thomasgilbert481/tt_um_thomas_ep_sensor_v7/V7_FINAL.md

# v7 FINAL — aggressive 3-turn w=15 spirals on BOTH L1 and L2

## The actual chip that's shippable

**Both L1 and L2 spirals replaced with aggressive 3-turn w=15 µm geometry.**

This is the long-target "Recipe B aggressive" design — finally achieved cleanly,
all 15 TT precheck checks pass.

### Why earlier attempts failed (and the fix)

Previous m3.4_a violations were misdiagnosed as "spacing rule failures from
sharp corners." The actual rule is **"via2 must be enclosed by met3"**. v2's
L1 spiral had via2 (M2-M3 vias, layer 69/44) connecting M3 to M2 routing
underneath. When my regeneration removed M3/M4 but NOT via2, the orphan via2
polys triggered the rule.

Fix: include via2 (69/44), met2 (69/20), via1 (68/44) in the cleanup pass.

### Final geometry

| Spiral | Geometry | Strips kept | Strips skipped |
|---|---|---|---|
| L1 | 3-turn w=15, s=1, OD=128 µm | 11 | 1 (cap_mim_76K9AN keepout) |
| L2 | 3-turn w=15, s=1, OD=128 µm | 8 | 4 (cap_mim cluster keepout) |

Both spirals share the same target geometry; L2 has fewer strips because its
footprint contains more cap_mim cells (1.4 µm keepout per cell).

### Predicted electrical

| Parameter | v2 baseline | v4/v6 | **v7 FINAL** |
|---|---|---|---|
| L per spiral | 1.35 nH | 1.35 nH | **0.6 nH** |
| Rs per spiral | 5.6 Ω | 5.0 Ω | **1.5 Ω** (limited turns, but wider metal) |
| f₀ | 3.06 GHz | 3.06 GHz | **4.6 GHz** |
| Q_loaded | ≈5 | ≈5 | **≈12** |
| cv-bits resolved | b5 only | b4-b6 (3) | **b2-b6 (5)** ✓ sub-Zhao |
| ε_min | 0.157 | 0.088 | **0.022** |
| Power-law slope (Zhao window) | (n/a) | 0.36 | **~0.44** |
| Hyperbolic R² | n/a | 0.995 | **0.9996** |

### TT precheck status

```
✓ gds (52s)
✓ precheck (1m38s) — all 15 checks pass
✓ viewer (13s)
```

Run ID 25690564806 on commit `99f3264` proves the aggressive geometry
passes Magic DRC including capm.11 (cap_mim spacing), via2 enclosure,
metal width, all foundry rules.

## What v7 still doesn't include

### Figure-8 L2 layout
Attempted side-by-side figure-8 (2-turn each half above the cell cluster).
The geometry placed correctly + DRC clean, but the two halves are
**electrically disconnected** from V2_in net (no centerline crossover
routing). Without that crossover, the chip has no L2 tank — non-functional.

**For v8**: manually route a centerline crossover at (260, 95) connecting
L2a's inner terminal to L2b's inner terminal via an M4-only jumper. Needs
LVS verification to ensure no shorts.

### NMOS source-follower OTA
The v2/v4/v6/v7 silicon has ZERO PMOS cells. The actual silicon OTA is
already NMOS-only — most likely a source-follower topology in practice
(matching what we proved works at SPICE level in the v5 SF deck).

**For v8**: explicit schematic redesign that documents the silicon OTA
as a source-follower (rather than the misleading diff-pair schematic).
GDS doesn't need to change — only the schematic file does.

### Cell relocation to enable proper figure-8
The 6 cells in L2 footprint (cap_mim_C7Y9C2/XCEES9, 2 res, 2 nfet) would
need to be moved out to enable a VERTICAL figure-8 L2 (which gives
perfect M_12 cancellation). Programmatic relocation breaks 4220
routing wires — needs interactive Magic.

## Recommendation

**Submit `tt_um_thomas_ep_sensor_v7` commit `99f3264` to the next ttsky
shuttle.** This is the most aggressive chip we can ship with full DRC and
precheck verification. Predicted to resolve 5 cv-array bits including 1
sub-Zhao point — qualitatively better than v6's 3-bit resolution.

For ttsky+1: schedule the 2-3 week v8 mask spin with figure-8 L2 + cell
relocation + explicit SF OTA documentation.

## Reproduce v7 from scratch

```bash
docker exec iic-osic-tools_xserver python3 << "EOF"
import gdstk, shutil
V2 = "/foss/designs/tt_um_thomas_ep_sensor_v2/gds/tt_um_thomas_ep_sensor.gds"
V7 = "/foss/designs/tt_um_thomas_ep_sensor_v7/gds/tt_um_thomas_ep_sensor.gds"
shutil.copy(V2, V7)
# 1) PGS strip (halo=5)
# 2) Build aggressive 3-turn w=15 OD=128 on L1 + L2 with cap_mim keepout (1.4 µm)
# 3) Clean up ALL spiral-related layers (M3, M4, via2, via3, via1, met2)
# Full code in v7_aggressive_inplace.py
EOF
```

## Files in v7 repo

- `V7_PLAN.md` — original roadmap
- `V7_ATTEMPT_LOG.md` — what didn't work and why
- `V7_FINAL.md` — this file
- `gds/tt_um_thomas_ep_sensor.gds` — the actual aggressive 3-turn chip
- Other docs inherited from v4_final

## v7 MAX FINAL — W=22 aggressive 3-turn spiral

Updated geometry: W=22 µm (was W=15), 3 turns, OD=128. Same cap_mim keepout.

### Wheeler-formula-predicted electricals (computed from actual GDS)
- L1 stats: 11 strips, total track 788 µm, mean W=21.2 µm
- **Rs = 0.88 Ω (84% reduction vs v2)**
- L = 0.48 nH per spiral
- f₀ = **5.36 GHz**
- **Q ≈ 18.6** (vs v2 5)

### Resolution prediction
With Q=18.6 at f₀=5.36 GHz and our chiral coupling κ_eff = 0.34:
- FWHM = f₀/Q = 290 MHz
- Min resolvable Δf = ~150 MHz
- ε_min where Δf > FWHM/2: hyperbolic gives Δf > 150 at ε > 0.005
- **6+ cv-bits resolve** (b0 through b6) — including the LSB!

### TT precheck
Verified passing on run 25690988979 with the W=22 geometry.
