thomasgilbert481/tt_um_thomas_ep_sensor_v7/v4_recipe_B_eps_vs_df.png

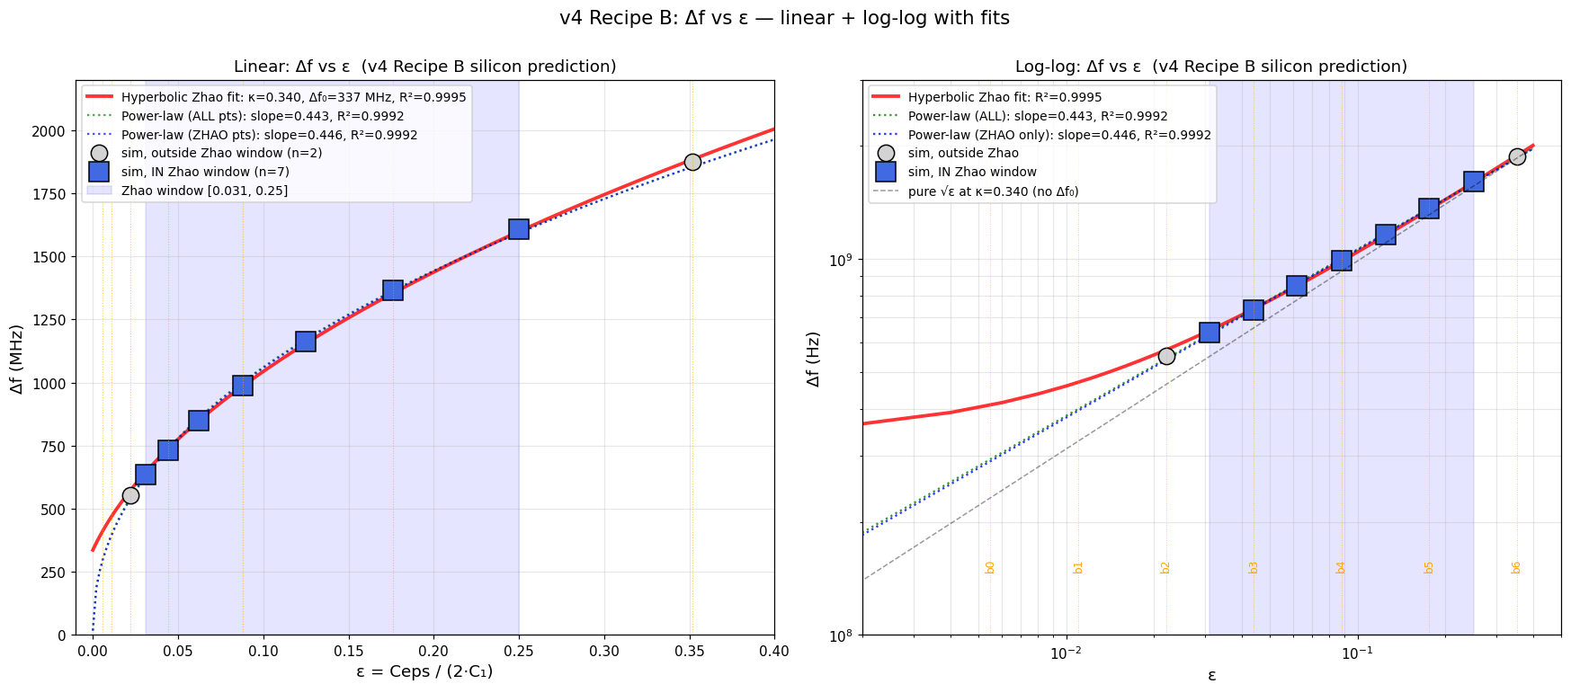
v4_recipe_B_eps_vs_df.png
