thomasgilbert481/tt_um_thomas_ep_sensor_v7/v4_recipe_B_transmission.png

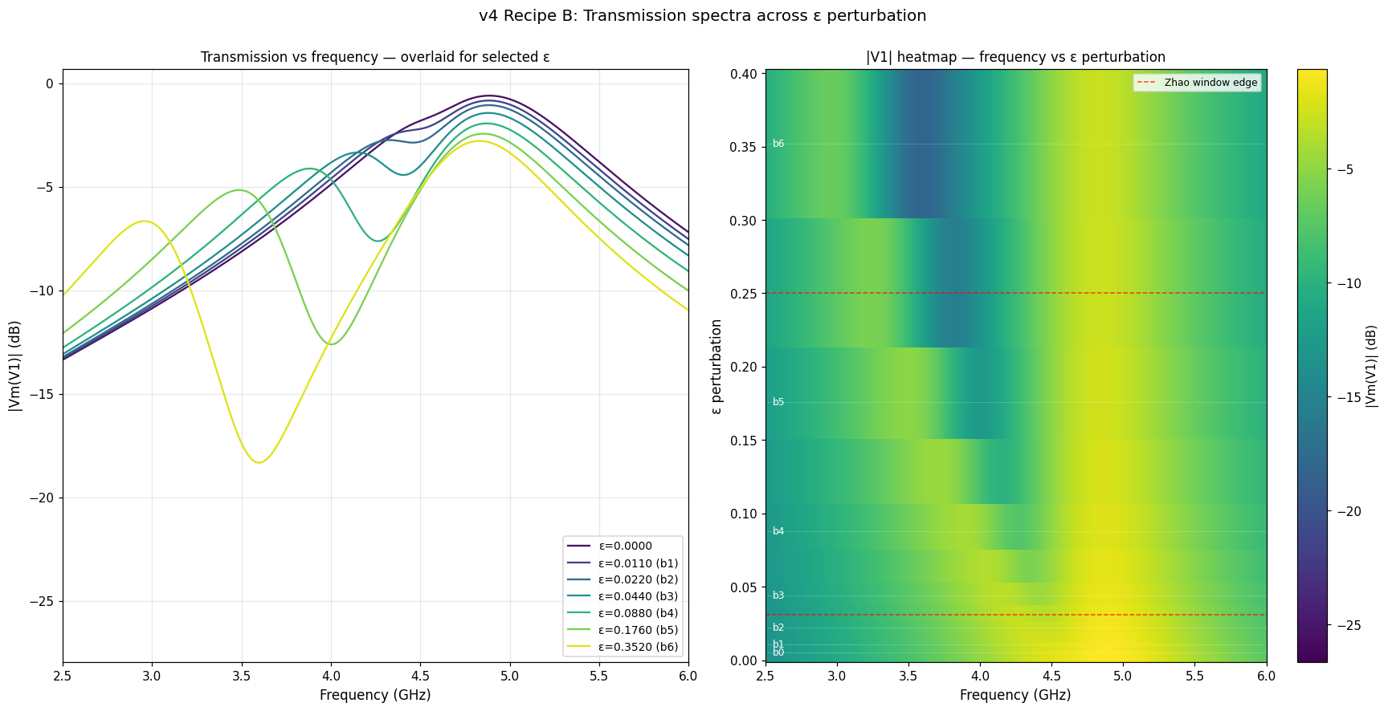
v4_recipe_B_transmission.png
