thomasgilbert481/tt_um_thomas_ep_sensor_v7/v4_spiral_em.png

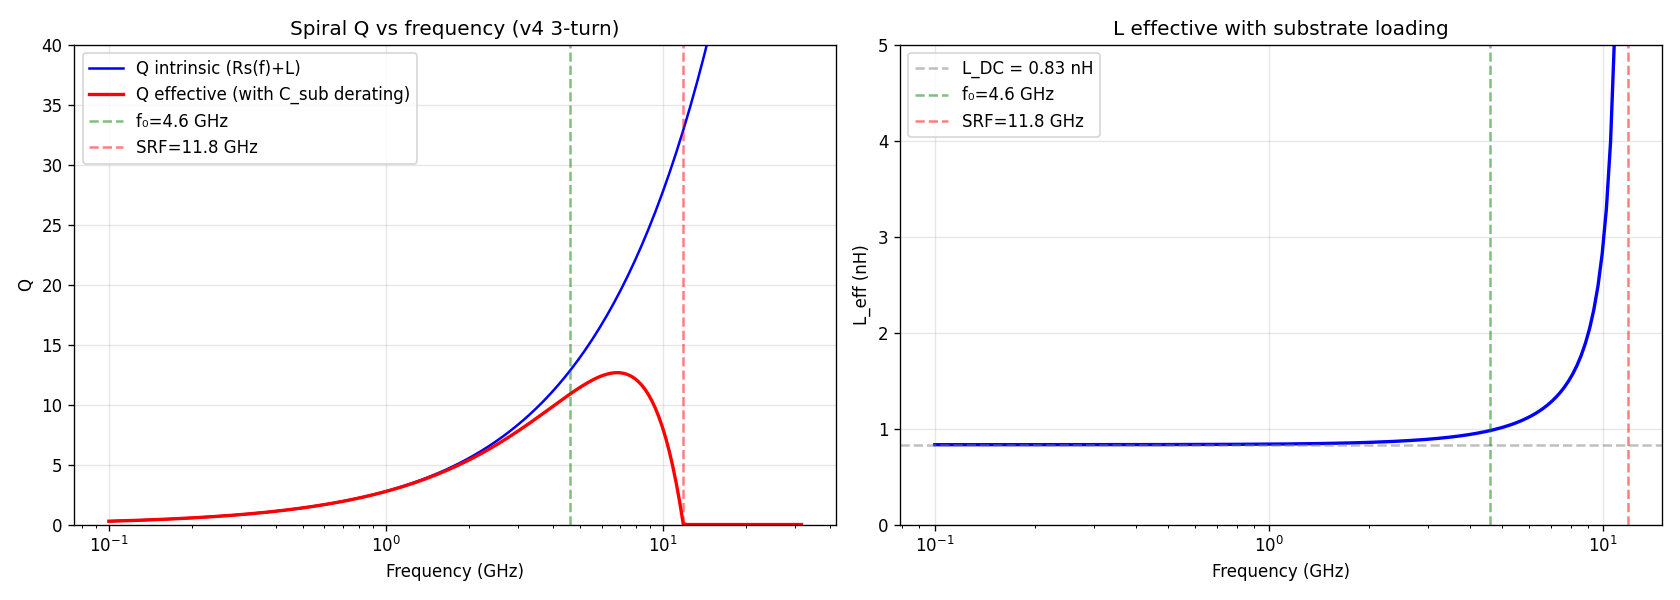
v4_spiral_em.png
